Tinkerforge/servo-brick/software/examples/labview/Example Configuration.vi.png

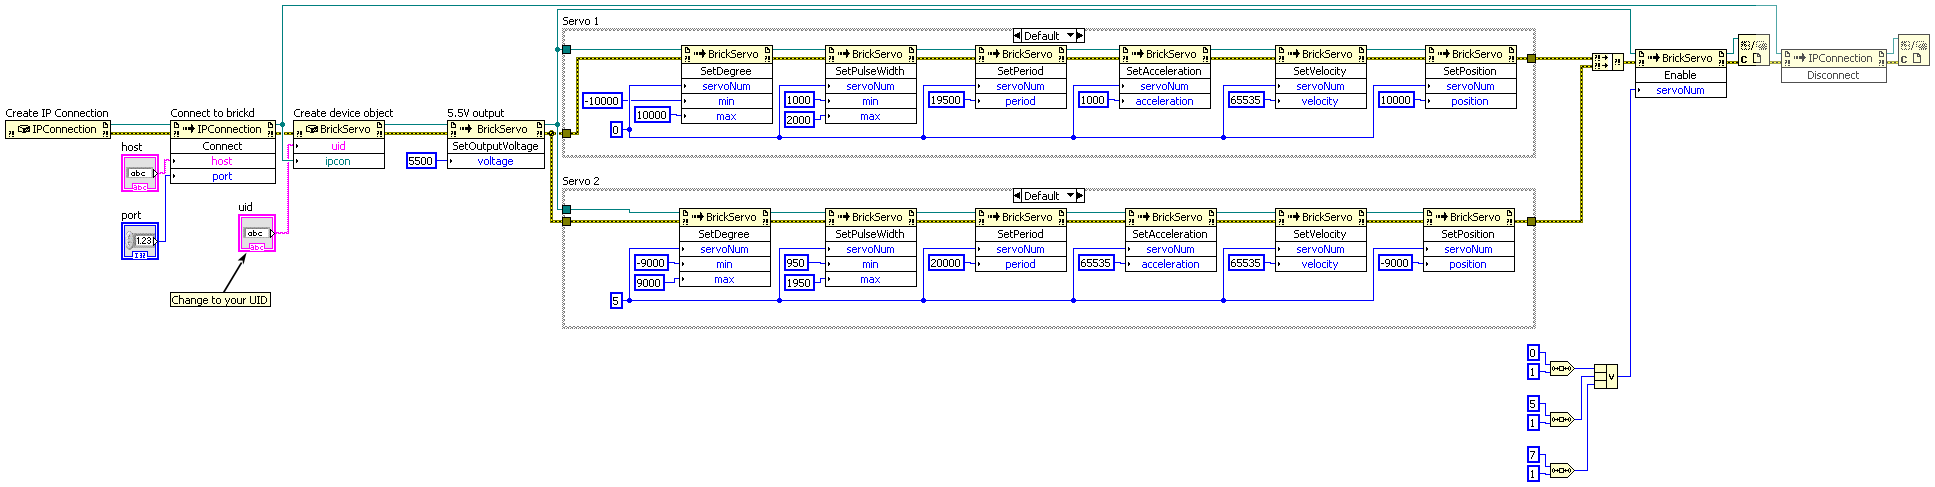
software/examples/labview/Example Configuration.vi.png
