Tinkerforge/servo-brick/hardware/servo-schematic.pdf

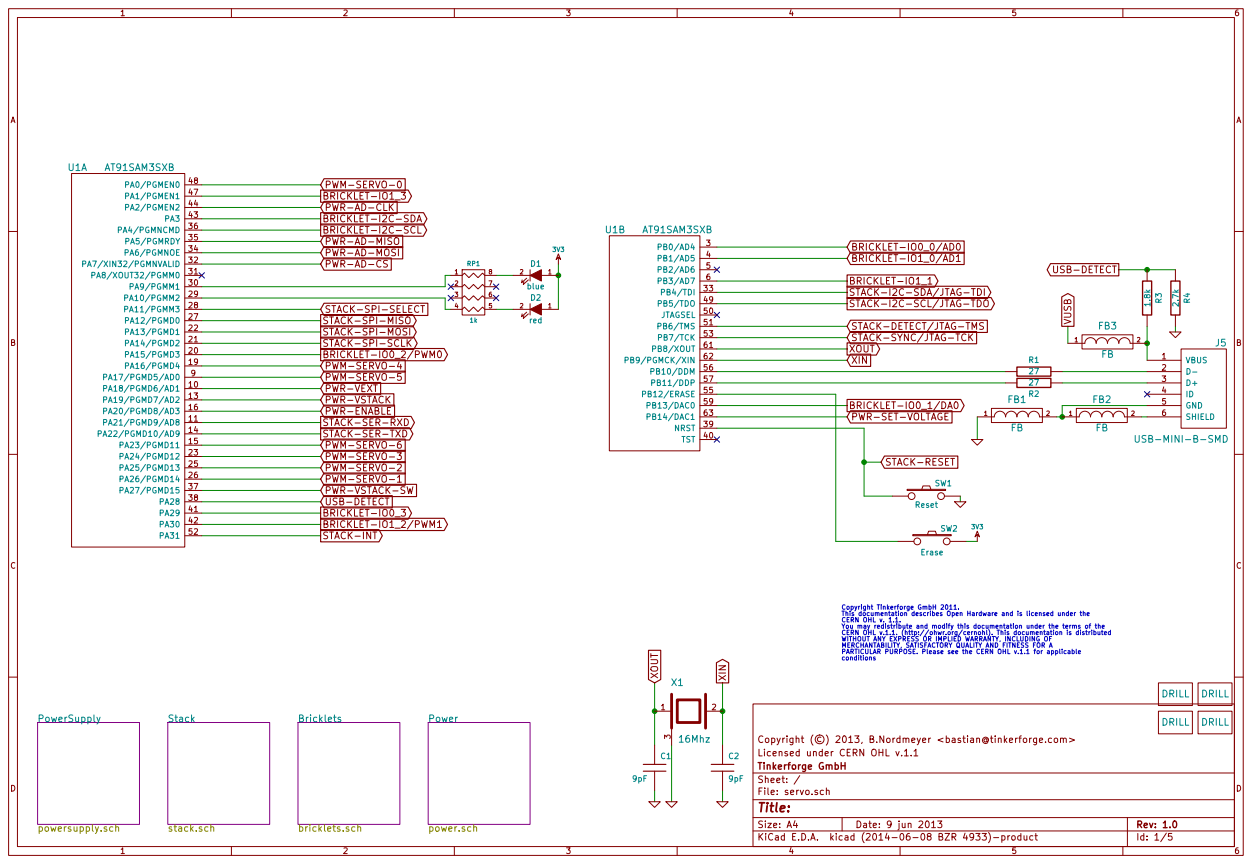
[picture p3: page 1]

BRICKLET-IO1_1
STACK-I2C-SDA/JTAG-TDI
STACK-I2C-SCL/JTAG-TDO

STACK-DETECT/JTAG-TMS
STACK-SYNC/JTAG-TCK
XOUT
XIN

Copyright Tinkerforge GmbH 2011. This documentation describes Open Hardware and is licensed under the CERN OHL v. 1.1. You may redistribute and modify this documentation under the terms of the CERN OHL v.1.1. (http://ohwr.org/cernohl). This documentation is distributed WITHOUT ANY EXPRESS OR IMPLIED WARRANTY, INCLUDING OF MERCHANTABILITY, SATISFACTORY QUALITY AND FITNESS FOR A

PARTICULAR PURPOSE. Please see the CERN OHL v.1.1 for applicable
conditions

Licensed under CERN OHL v.1.1 Copyright (©) 2013, B.Nordmeyer <bastian@tinkerforge.com>

Id: 1/5 Title: File: servo.sch Sheet: / Tinkerforge GmbH

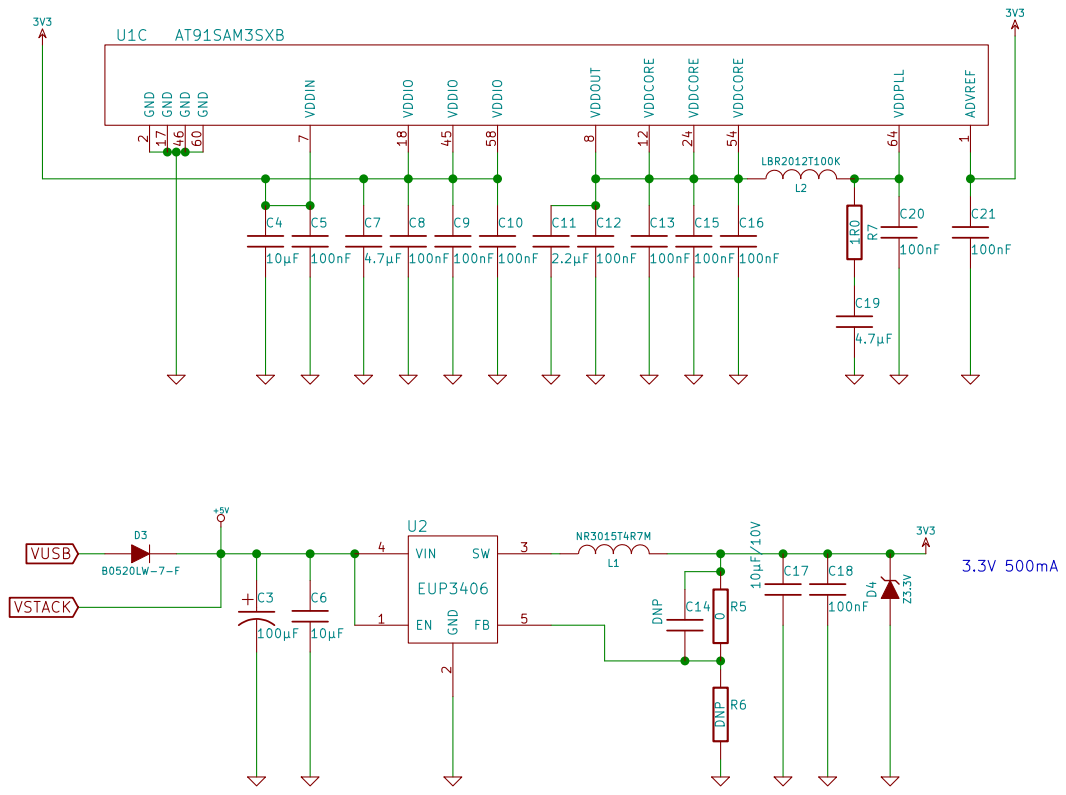
[picture p4: page 2]

8 GND 60 VDDCORE 12 VDDCORE 24 VDDCORE 54 VDDPLL 64 VDDIO 45 GND 46 GND 17 VDDIO 18 VDDIO 58

Licensed under CERN OHL v.1.1 Copyright (©) 2013, B.Nordmeyer <bastian@tinkerforge.com>

D Date: 9 jun 2013

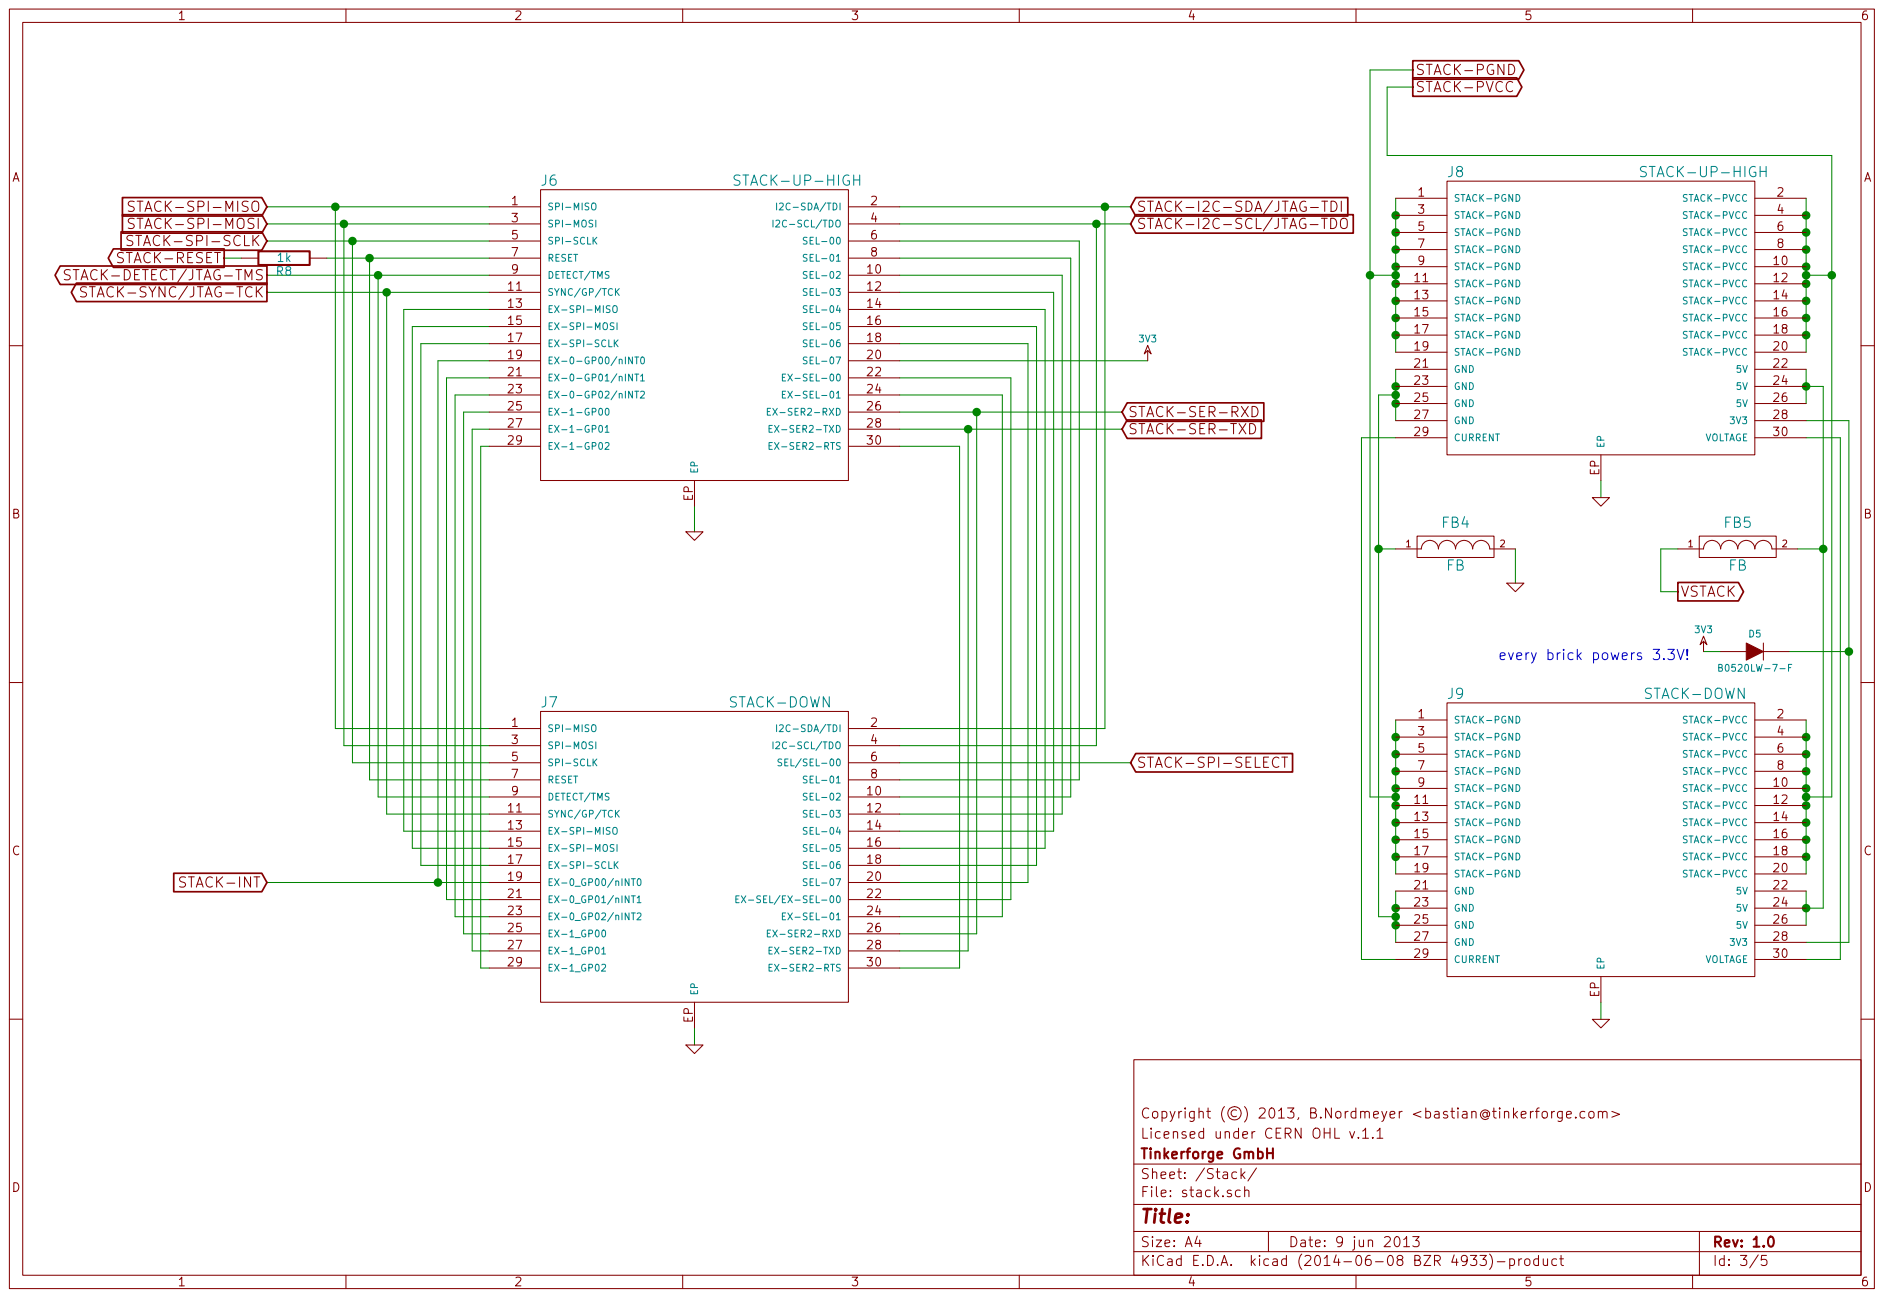
[picture p5: page 3]

STACK-SPI-MISO
STACK-SPI-MOSI
STACK-SPI-SCLK
STACK-RESET
STACK-DETECT/JTAG-TMS
STACK-SYNC/JTAG-TCK

STACK-I2C-SDA/JTAG-TDI
STACK-I2C-SCL/JTAG-TDO

Licensed under CERN OHL v.1.1 Copyright (©) 2013, B.Nordmeyer <bastian@tinkerforge.com>

Id: 3/5 Title: File: stack.sch Sheet: /Stack/ Tinkerforge GmbH

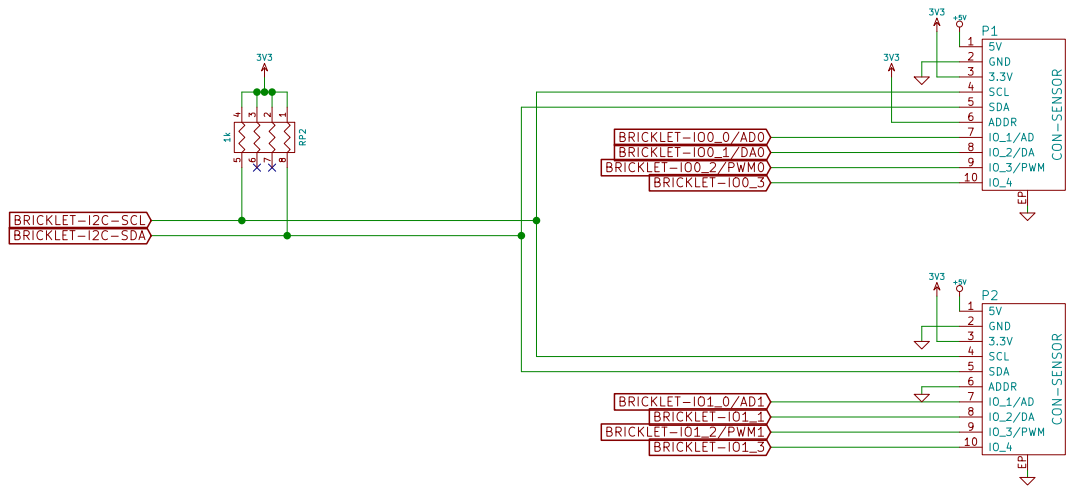
[picture p6: page 4]

Id: 4/5 Title: File: bricklets.sch Sheet: /Bricklets/ Tinkerforge GmbH

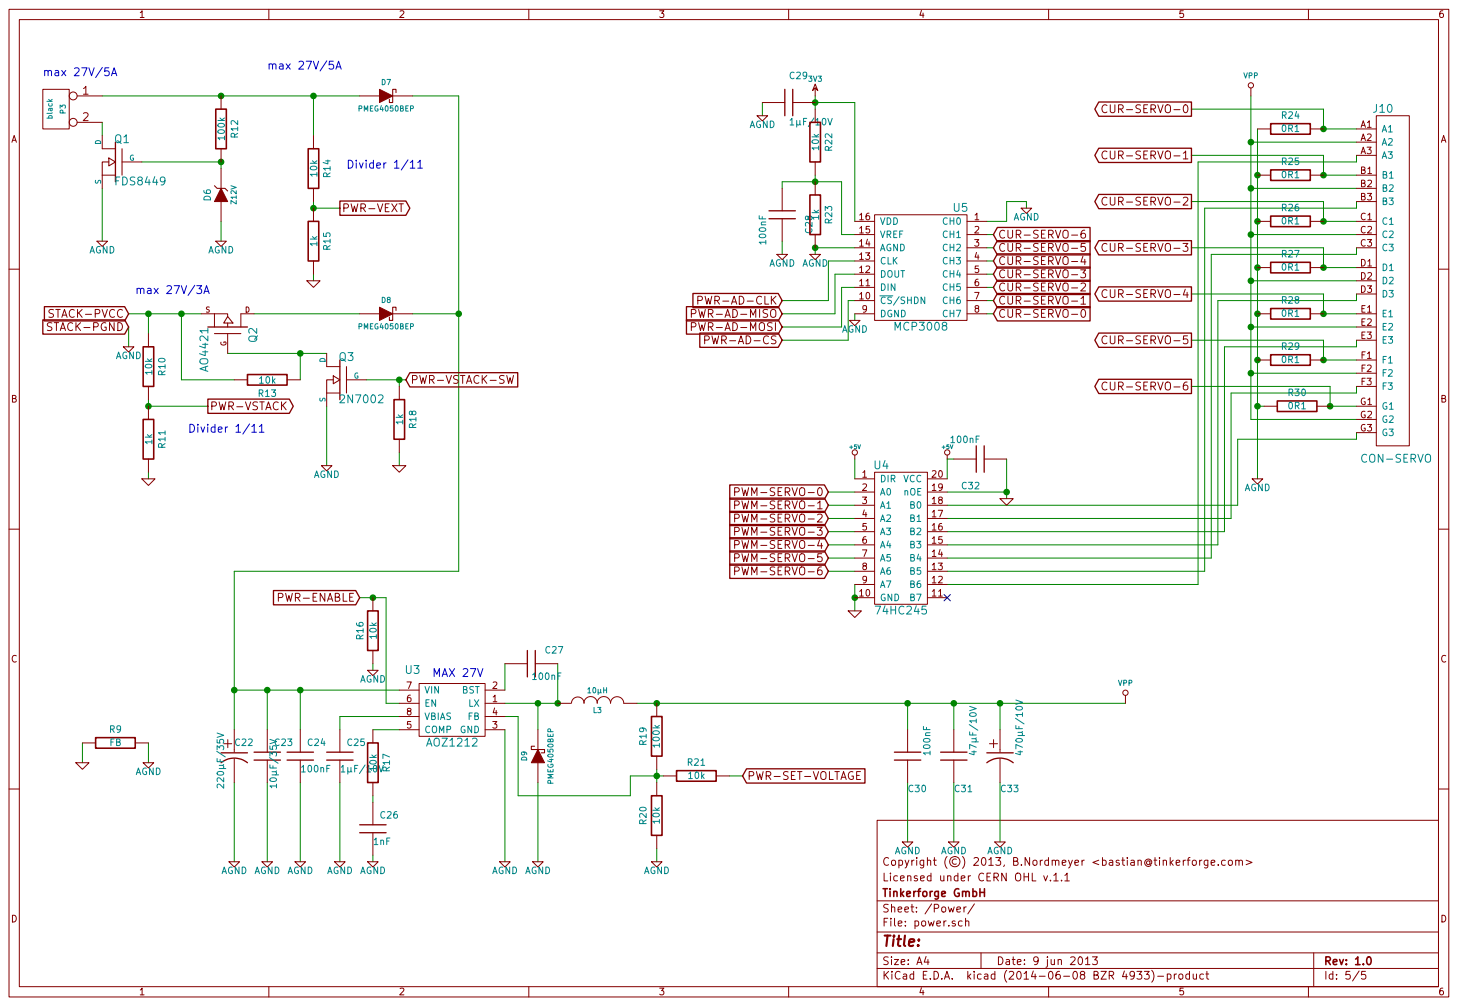
[picture p7: page 5]

Licensed under CERN OHL v.1.1 Copyright (©) 2013, B.Nordmeyer <bastian@tinkerforge.com> C23 10µF/35V

File: power.sch Sheet: /Power/ Tinkerforge GmbH
