Tinkerforge/servo-brick/hardware/servo.kicad_pcb

## KiCad design hardware/servo.kicad_pcb (2018-07-25)

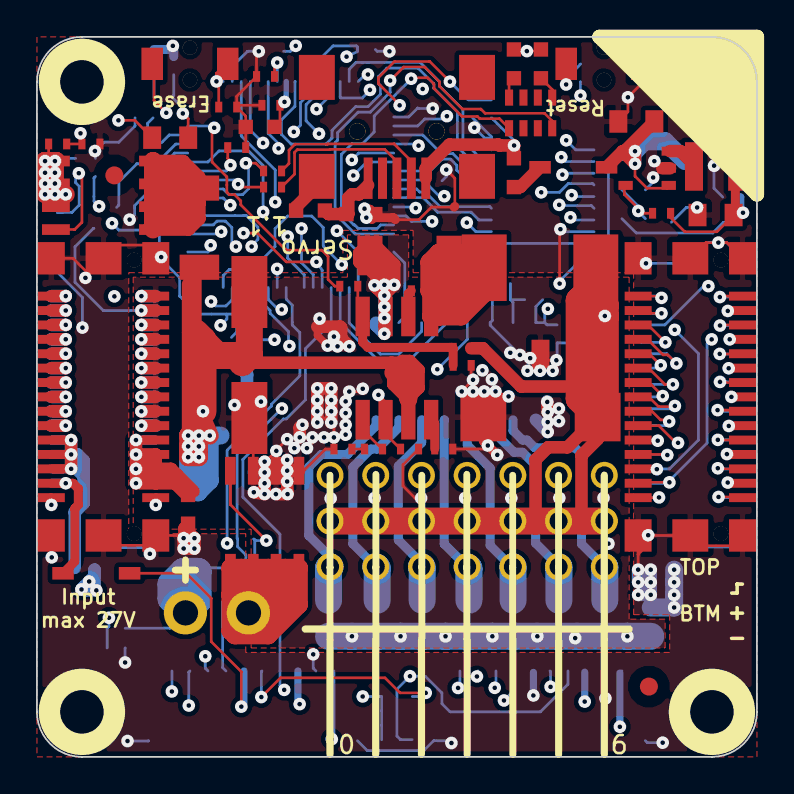
[picture p8: board servo.kicad_pcb from above]

Board: 4 copper layers, 40.0 x 40.0 mm, 113 parts (0 on the bottom side), 116 nets.

Parts:
C1, C2: 9pF; C0402
C3: 100µF; 3528-21
C4, C6: 10µF; C0805
C5, C8, C9, C10, C12, C13, C15, C16, C18, C20, C21, C27, C28, C32: 100nF; C0402
C7, C19: 4.7µF; C0603
C11: 2.2µF; C0603
C14: DNP; C0402
C17: 10µF/10V; C0805
C22: 220µF/35V; ELKO_83
C23: 10µF/35V; C1206
C24, C30: 100nF; C0603
C25: 1µF/10V; C0402
C26: 1nF; C0402
C29: 1µF/10V; 0402
C31: 47µF/10V; C1206
C33: 470µF/10V; 7343
D1: blue; D0603
D2: red; D0603
D3, D5: B0520LW-7-F; SOD-123
D4: Z3.3V; SOD-123
D6: Z12V; SOD-123
D7, D8, D9: PMEG4050BEP; SOD-128
FB1, FB2, FB3, FB4, FB5: FB; C0603
Fiducial_Mark: VAL**; Fiducial_Mark
Fiducial_Mark#2, Fiducial_Mark#3, Fiducial_Mark#4: VAL**; Fiducial_Mark
J1, J2, J3, J4: DRILL; DRILL_NP
J5: USB-MINI-B-SMD
J6, J8: STACK-UP-HIGH; BTB08-ACS-TOP
J7, J9: STACK-DOWN; BTB08-ACS-BTM
J10: CON-SERVO; CON-Servo
L1: NR3015T4R7M; NR3030
L2: LBR2012T100K; C0805
L3: 10µH; SRP7030
P1, P2: CON-SENSOR
P3: black; OQ_2P
Q1: FDS8449; SOIC-8-MOSFET
Q2: AO4421; SOIC-8-MOSFET
Q3: 2N7002; SOT23GDS
R1, R2: 27; R0402
R3: 1.8k; R0402
R4: 2.7k; R0402
R5: 0; R0603
R6: DNP; R0603
R7: 1R0; R0402
R8, R11, R15, R18, R23: 1k; R0402
R9: FB; C0603
R10, R13, R14, R16, R17, R20, R21, R22: 10k; R0402
R12, R19: 100k; R0402
R24, R25, R26, R27, R28, R29, R30: 0R1; R0805
RP1, RP2: 1k; 4X0603
Ref**: Val**; Logo_31x31m
SW1: Reset; TACT-SWITCH
SW2: Erase; TACT-SWITCH
U1: AT91SAM3SXB; LQFP64
U2: EUP3406; SOT23-5
U3: AOZ1212; SO-8
U4: 74HC245; TSSOP20
U5: MCP3008; SOIC16
VAL: CE_5mm
VAL#2: WEEE_7mm
X1: 16Mhz; CRYSTAL_3225

Connections:
3V3: C4.1, C5.1, C7.1, C8.1, C9.1, C10.1, C14.1, C17.1, C18.1, C21.1, C29.1, D1.1, D2.1, D4.2, D5.1, J6.20, L1.2, P1.3, P1.6, P2.3, R5.1, R22.2, RP2.1, RP2.2, RP2.3, RP2.4, SW2.2, U1.1, U1.7, U1.18, U1.45, U1.58, U5.16
BRICKLET-I2C-SCL: P1.4, P2.4, RP2.5, U1.36
BRICKLET-I2C-SDA: P1.5, P2.5, RP2.8, U1.43
BRICKLET-IO0_0/AD0: P1.7, U1.3
BRICKLET-IO0_1/DA0: P1.8, U1.59
BRICKLET-IO0_2/PWM0: P1.9, U1.20
BRICKLET-IO0_3: P1.10, U1.41
BRICKLET-IO1_0/AD1: P2.7, U1.4
BRICKLET-IO1_1: P2.8, U1.6
BRICKLET-IO1_2/PWM1: P2.9, U1.42
BRICKLET-IO1_3: P2.10, U1.47
CUR-SERVO-0: J10.A1, R24.1, U5.8
CUR-SERVO-1: J10.B1, R25.1, U5.7
CUR-SERVO-2: J10.C1, R26.1, U5.6
CUR-SERVO-3: J10.D1, R27.1, U5.5
CUR-SERVO-4: J10.E1, R28.1, U5.4
CUR-SERVO-5: J10.F1, R29.1, U5.3
CUR-SERVO-6: J10.G1, R30.1, U5.2
GND: C1.2, C2.2, C3.2, C4.2, C5.2, C6.2, C7.2, C8.2, C9.2, C10.2, C11.2, C12.2, C13.2, C15.2, C16.2, C17.2, C18.2, C19.2, C20.2, C21.2, C32.2, D4.1, FB1.1, FB4.2, J6.EP, J7.EP, J8.EP, J9.EP, P1.2, P1.EP, P2.2, P2.6, P2.EP, R4.1, R6.2, R9.2, R11.1, R15.1, R18.1, SW1.2, U1.2, U1.17, U1.46, U1.60, U2.2, U4.9, U4.10, U4.19, X1.3
unnamed: C11.1, C12.1, C13.1, C15.1, C16.1, L2.1, U1.8, U1.12, U1.24, U1.54
unnamed: C14.2, R5.2, R6.1, U2.5
unnamed: C19.1, R7.1
unnamed: C20.1, L2.2, R7.2, U1.64
unnamed: C22.1, C23.1, C24.1, D7.2, D8.2, U3.7
unnamed: C25.1, U3.8
unnamed: C26.1, R17.1
unnamed: C27.1, D9.2, L3.1, U3.1
unnamed: C27.2, U3.2
unnamed: C28.2, R22.1, R23.2, U5.15
unnamed: D1.2, RP1.8
unnamed: D2.2, RP1.5
unnamed: D5.2, J8.28, J9.28
unnamed: D6.2, Q1.G, R12.2
unnamed: D7.1, P3.1, R12.1, R14.2
unnamed: D8.1, Q2.D
unnamed: FB1.2, FB2.1, J5.5
unnamed: FB2.2, J5.6
unnamed: FB3.2, J5.1, R3.1
unnamed: FB4.1, J8.21, J8.23, J8.25, J8.27, J9.21, J9.23, J9.25, J9.27
unnamed: FB5.2, J8.22, J8.24, J8.26, J9.22, J9.24, J9.26
unnamed: J5.2, R1.1
unnamed: J5.3, R2.1
unnamed: J6.6, J7.8
unnamed: J6.7, J7.7, R8.1
unnamed: J6.8, J7.10
unnamed: J6.10, J7.12
unnamed: J6.12, J7.14
unnamed: J6.13, J7.13
unnamed: J6.14, J7.16
unnamed: J6.15, J7.15
unnamed: J6.16, J7.18
unnamed: J6.17, J7.17
unnamed: J6.18, J7.20
unnamed: J6.21, J7.21
unnamed: J6.22, J7.22
unnamed: J6.23, J7.23
unnamed: J6.24, J7.24
unnamed: J6.25, J7.25
unnamed: J6.27, J7.27
unnamed: J6.29, J7.29
unnamed: J6.30, J7.30
unnamed: J8.29, J9.29
unnamed: J8.30, J9.30
unnamed: J10.A3, U4.12
unnamed: J10.B3, U4.13
unnamed: J10.C3, U4.14
unnamed: J10.D3, U4.15
unnamed: J10.E3, U4.16
unnamed: J10.F3, U4.17
unnamed: J10.G3, U4.18
unnamed: L1.1, U2.3
unnamed: P3.2, Q1.D
unnamed: Q2.G, Q3.D, R13.2
unnamed: R1.2, U1.56
unnamed: R2.2, U1.57
unnamed: R17.2, U3.5
unnamed: R19.2, R20.1, R21.2, U3.4
unnamed: RP1.1, U1.30
unnamed: RP1.4, U1.29
unnamed: SW2.1, U1.55
PWM-SERVO-0: U1.48, U4.2
PWM-SERVO-1: U1.26, U4.3
PWM-SERVO-2: U1.25, U4.4
PWM-SERVO-3: U1.23, U4.5
PWM-SERVO-4: U1.19, U4.6
PWM-SERVO-5: U1.9, U4.7
PWM-SERVO-6: U1.15, U4.8
PWR-AD-CLK: U1.44, U5.13
PWR-AD-CS: U1.32, U5.10
PWR-AD-MISO: U1.35, U5.12
PWR-AD-MOSI: U1.34, U5.11
PWR-ENABLE: R16.2, U1.16, U3.6
PWR-SET-VOLTAGE: R21.1, U1.63
PWR-VEXT: R14.1, R15.2, U1.10
PWR-VSTACK: R10.1, R11.2, U1.13
PWR-VSTACK-SW: Q3.G, R18.2, U1.37
STACK-DETECT/JTAG-TMS: J6.9, J7.9, U1.51
STACK-I2C-SCL/JTAG-TDO: J6.4, J7.4, U1.49
STACK-I2C-SDA/JTAG-TDI: J6.2, J7.2, U1.33
STACK-INT: J6.19, J7.19, U1.52
STACK-PGND: C22.2, C23.2, C24.2, C25.2, C26.2, C28.1, C29.2, C30.2, C31.2, C33.2, D6.1, D9.1, J8.1, J8.3, J8.5, J8.7, J8.9, J8.11, J8.13, J8.15, J8.17, J8.19, J9.1, J9.3, J9.5, J9.7, J9.9, J9.11, J9.13, J9.15, J9.17, J9.19, Q1.S, Q3.S, R9.1, R16.1, R20.2, R23.1, R24.2, R25.2, R26.2, R27.2, R28.2, R29.2, R30.2, U3.3, U5.1, U5.9, U5.14
STACK-PVCC: J8.2, J8.4, J8.6, J8.8, J8.10, J8.12, J8.14, J8.16, J8.18, J8.20, J9.2, J9.4, J9.6, J9.8, J9.10, J9.12, J9.14, J9.16, J9.18, J9.20, Q2.S, R10.2, R13.1
STACK-RESET: R8.2, SW1.1, U1.39
STACK-SER-RXD: J6.26, J7.26, U1.11
STACK-SER-TXD: J6.28, J7.28, U1.14
STACK-SPI-MISO: J6.1, J7.1, U1.27
STACK-SPI-MOSI: J6.3, J7.3, U1.22
STACK-SPI-SCLK: J6.5, J7.5, U1.21
STACK-SPI-SELECT: J7.6, U1.28
STACK-SYNC/JTAG-TCK: J6.11, J7.11, U1.53
USB-DETECT: R3.2, R4.2, U1.38
VPP: C30.1, C31.1, C33.1, J10.A2, J10.B2, J10.C2, J10.D2, J10.E2, J10.F2, J10.G2, L3.2, R19.1
VSTACK: C3.1, C6.1, C32.1, D3.2, FB5.1, P1.1, P2.1, U2.1, U2.4, U4.1, U4.20
VUSB: D3.1, FB3.1
XIN: C2.1, U1.62, X1.2
XOUT: C1.1, U1.61, X1.1
