Tinkerforge/servo-brick/(commit log)

2011-08-25 initial hardware source commit
    [bricklets.sch, power.sch, powersupply.sch, servo.brd, servo.sch, stack.sch]
2011-08-25 change voltage epsilon from 200 to 1000mV
2011-08-25 fix missing parameters in debug messages
    [communication.c]
2011-08-26 remove adc conversion in tick task, bricklib uses freerun now
2011-08-26 change diode PMEG1020EH -> B0520LW-7-F
    [powersupply.sch, servo.brd, stack.sch]
2011-09-06 add red led error status code
    [servo.c]
2011-09-08 use voltage epsilon to change between external and stack voltage
2011-09-08 compare external voltage for switching between external and stack voltage
2011-09-08 adapt servo numbering according to hardware numbering
2011-09-08 adapt servo numbering: current measurement was missing, now adapted
    [mcp3008.c]
2011-09-13 add java bindings and examples
    [ExampleCallback.java, ExampleConfiguration.java]
2011-09-15 fix copy and paste fail in java example comments
    [ExampleCallback.java]
2011-10-05 Remove Bindings and IP Connection (these are generated and they change too often) and rename bindings to examples
    [ExampleCallback.java, ExampleConfiguration.java, example_callback.c, example_configuration.c]
2011-11-24 set servo position once at startup
2012-02-13 No major changes - add fiducials on board - add revision on schematics
    [bricklets.sch, power.sch, powersupply.sch, servo.brd, servo.sch, stack.sch]
2012-03-05 Fix bug with timeouts on windows (through bricklib)
    [config.h]
2012-03-11 Fix bug with ADC calibration readout (through bricklib)
    [config.h]
2012-06-29 Add get_temperature and reset function (through bricklib)
    [config.h]
2012-11-30 Fix invalid parameter checks
    [communication.c]
2012-11-30 Add invalid parameter checks for servo_num parameter
2012-12-11 Avoid g++ warnings about missing casts in C examples
    [example_callback.c]
2013-01-09 Use specific device object for callbacks
2013-04-11 Add watchdog timer (restart after 16s of "deadlock")
2013-06-17 Add missing defines for enable/disable API for reached callbacks
    [communication.h, config.h]
2013-06-18 Add missing enable_position_reached_callback to examples
    [ExampleCallback.java, example_callback.c]
2013-06-27 Use tick_task to detect usb connect/disconnect instead of interrupt (through bricklib)
2014-01-14 perl: Fix warning about unsharing the $servo variable
2014-02-07 Add Mathematica examples
    [ExampleConfiguration.nb.txt]
2014-02-25 Add PWM example in C
2014-04-02 perl: Unify print style
2014-06-12 change voltage divider values
    [bricklets.sch, power.sch, powersupply.sch, servo.brd, servo.kicad_pcb, servo.sch, stack.sch]
2014-07-04 Add support SPI DMA (currently turned off by default)
2014-07-15 java: Replace System.console() usage with an Eclipse compatible pattern
    [ExampleCallback.java, ExampleConfiguration.java]
2014-11-25 Use new SPI protocol
2015-08-07 Use full device class name in Python examples
2015-08-12 Fix minor warnings in C/C++ examples
    [example_callback.c, example_configuration.c, example_pwm_generator.c]
2015-08-18 Add missing disable call in PWM example
    [example_pwm_generator.c]
2015-09-30 Generator based example cleanup
    [ExampleConfiguration.nb.txt]
2016-05-18 c: Add missing device destroy call
    [example_callback.c, example_configuration.c]
2016-07-01 Make the change UID comment more explicit
    [ExampleConfiguration.nb.txt]
2017-06-30 Add 3d information (tbc); fix direction of some diodes
    [bricklets.sch, power.sch, powersupply.sch, servo.sch, stack.sch]
2017-07-07 Add 3d information (final)
    [bricklets.sch, power.sch, powersupply.sch, servo.kicad_pcb, servo.sch, stack.sch]
2017-07-07 Servo Brick: Add 3d model (*.step & *.FCStd)
2017-08-01 Add 3d component: NR3030
    [servo.kicad_pcb]
2017-09-12 Add example for PWM Generator (Java)
2017-09-13 java: Fix mismatch between PWM example classname and filename
    [ExamplePWMGenerator.java]
2017-09-13 java: Make PWM example make the C/C++ example match more closely
2018-01-11 Increase version number (message duplication bug fix through bricklib)
    [config.h]
2018-02-20 Cleanup KiCad libraries config
    Ensure LibDir=kicad-libraries and LibName1=tinkerforge.
    Remove special library.
2018-07-25 Add new 3d model
    [servo.kicad_pcb]
2018-11-07 rust: Accept host names for ip connection, fix naming inconsistencies
    [example_callback.rs, example_configuration.rs]
2019-01-24 mqtt: Add examples.
    [example-configuration.txt]
2019-01-24 mqtt: Fix example header.
    [example-configuration.txt]
2019-01-24 mqtt: Remove executable bit in example permissions.
    [example-configuration.txt]
2019-01-24 mqtt: Minor example fixes.
    [example-configuration.txt]
2019-08-22 c: Adapt to bindings changes
    [example_callback.c]
2019-11-22 Make sure that Servo Brick output goes low if pulse width and position is set to 0.
2020-01-13 examples: mqtt: Remove trailing whitespace.
    [example-configuration.txt]
2020-04-07 examples: rust: Always block when calling bindings functions.
    [example_configuration.rs]
2021-10-25 Update KiCad link
    https://www.kicad.org/blog/2021/10/Avoid-links-to-former-kicad-domain/
