Tinkerforge/servo-brick/(notices)

Notices in the files:
hardware/servo.kicad_pcb:
Copyright Tinkerforge GmbH 2013.
